borisvolegov/furious/stl/L1 Frame Base Alignment Pin.STL

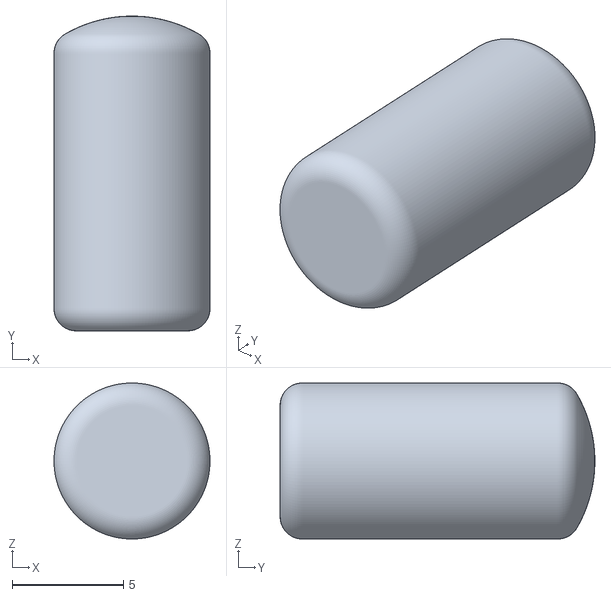
[picture p1: CAD file, 2023-03-07]
stl/L1 Frame Base Alignment Pin.STL
7.00 x 14.1 x 7.00
