borisvolegov/furious/stl/L1 Frame Base original.STL

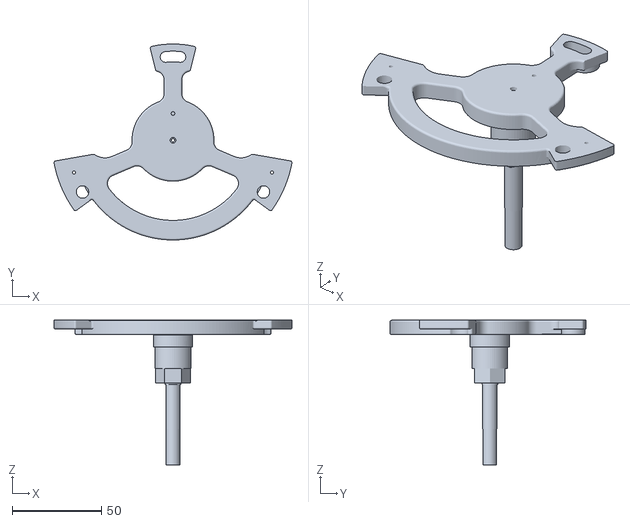
[picture p2: CAD file, 2023-03-07]
stl/L1 Frame Base original.STL
133.6 x 110.0 x 81.1
