borisvolegov/furious/stl/L1 Balance Shaft 2.STL

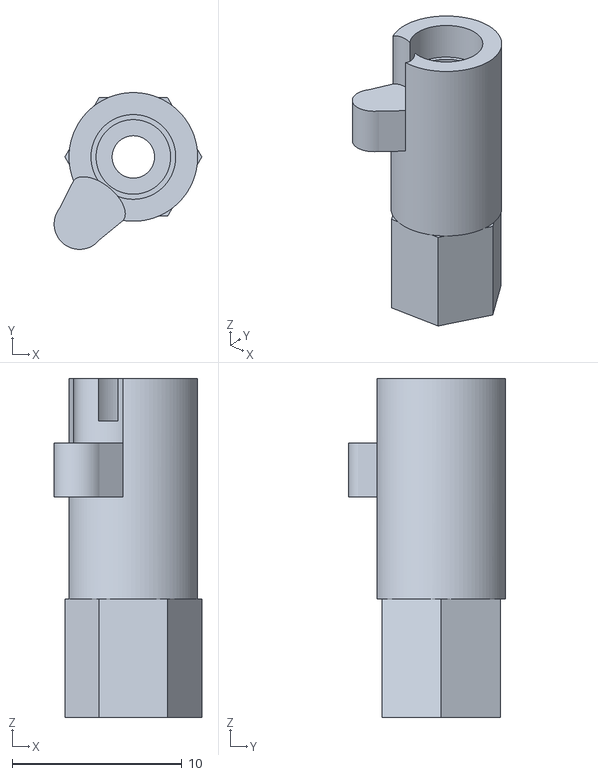
[picture p3: CAD file, 2023-03-07]
stl/L1 Balance Shaft 2.STL
8.71 x 9.25 x 20.0
