borisvolegov/furious/stl/L3 Frame Ring Gear.STL

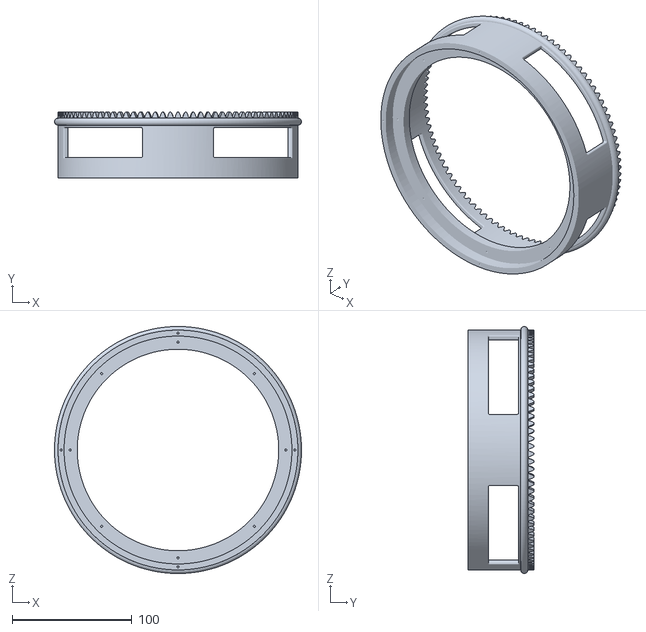
[picture p4: CAD file, 2023-03-07]
stl/L3 Frame Ring Gear.STL
206.0 x 54.9 x 206.0
