borisvolegov/furious/stl/2x1mm Bearing Spacer BINARY.stl

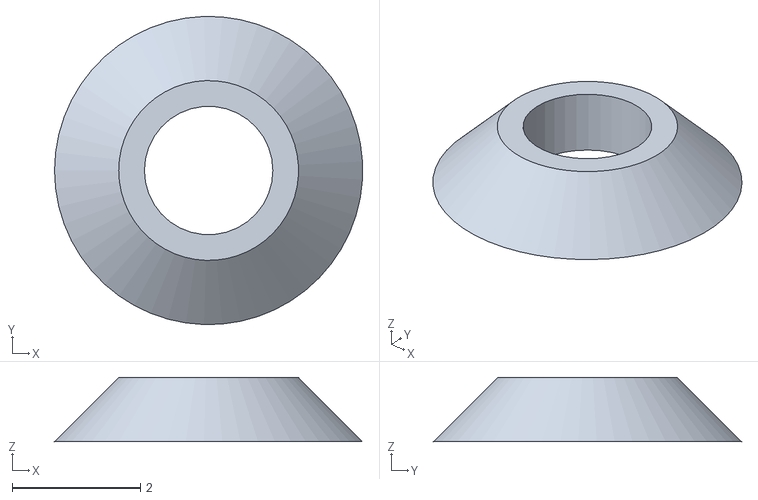
[picture p5: CAD file, 2023-03-07]
stl/2x1mm Bearing Spacer BINARY.stl
4.80 x 4.80 x 1.00
