borisvolegov/furious/stl/L3 Frame.STL

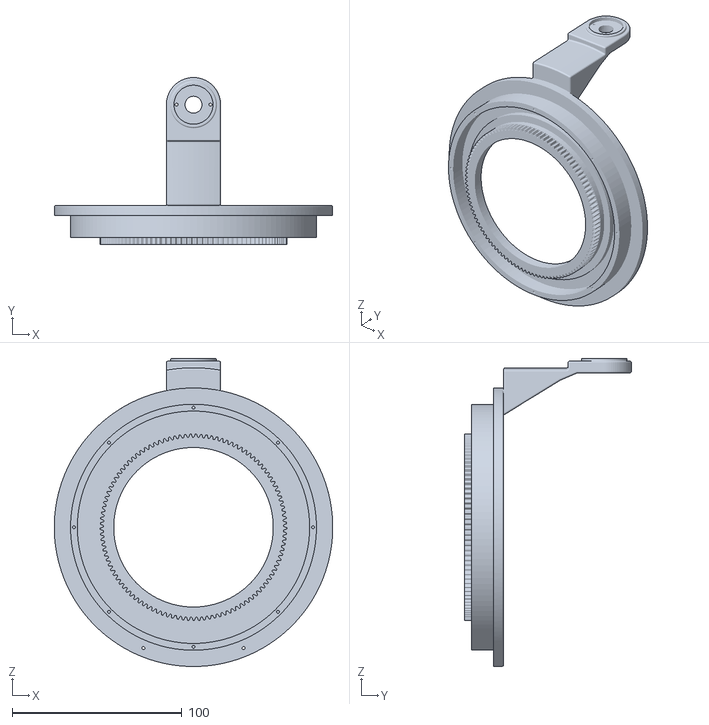
[picture p6: CAD file, 2023-03-07]
stl/L3 Frame.STL
164.2 x 98.4 x 181.6
