borisvolegov/furious/stl/L1 Escape Wheel.STL

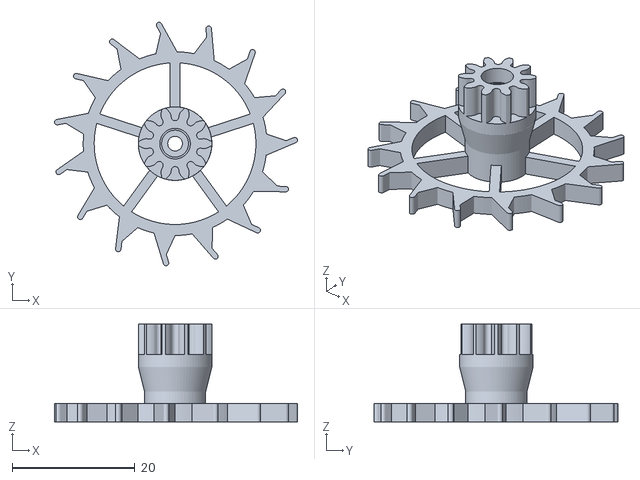
[picture p7: CAD file, 2023-03-07]
stl/L1 Escape Wheel.STL
39.7 x 39.8 x 16.0
