borisvolegov/furious/stl/L3 Crown Gear b.STL

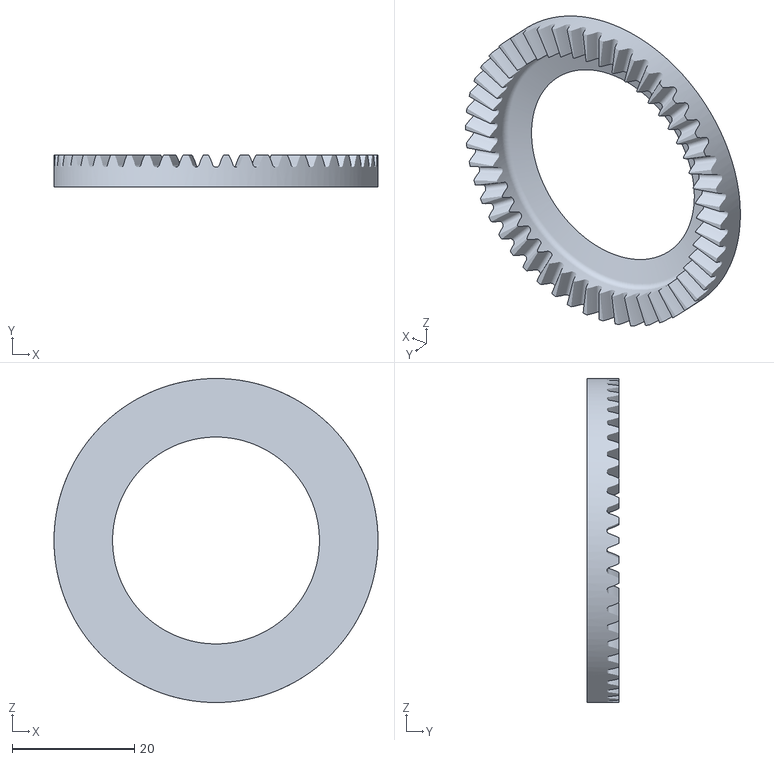
[picture p8: CAD file, 2023-03-07]
stl/L3 Crown Gear b.STL
53.0 x 5.30 x 53.0
