borisvolegov/furious/stl/L1 Fork 3.STL

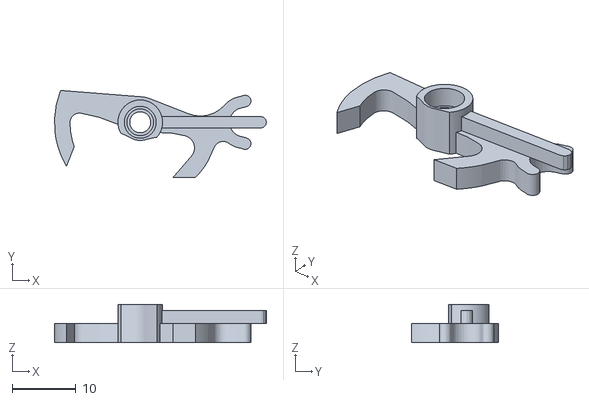
[picture p9: CAD file, 2023-03-07]
stl/L1 Fork 3.STL
33.2 x 13.7 x 6.00
