borisvolegov/furious/stl/L1 Bearing Spacer Upper.STL

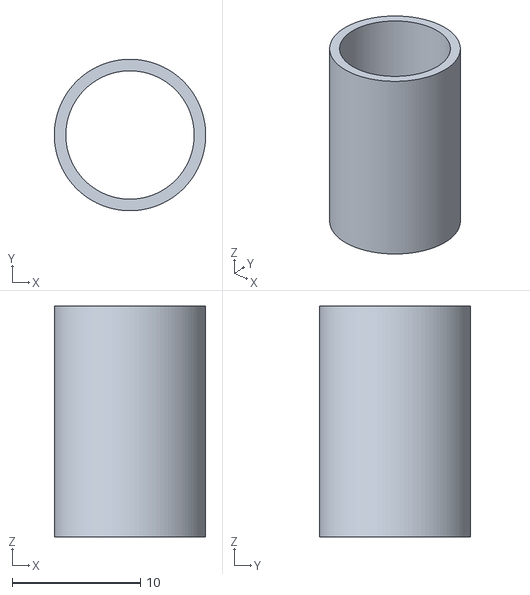
[picture p10: CAD file, 2023-03-07]
stl/L1 Bearing Spacer Upper.STL
11.8 x 11.8 x 18.0
