borisvolegov/furious/stl/L3 Bearing Race Upper.STL

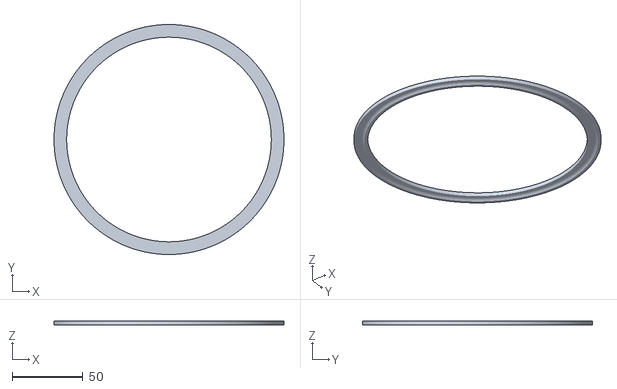
[picture p11: CAD file, 2023-03-07]
stl/L3 Bearing Race Upper.STL
163.0 x 163.0 x 2.50
