borisvolegov/furious/stl/L2 T25 M2 3mm Gear.STL

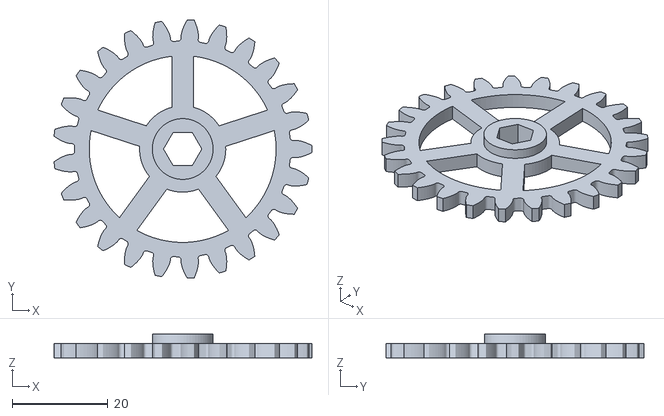
[picture p12: CAD file, 2023-03-07]
stl/L2 T25 M2 3mm Gear.STL
53.9 x 54.0 x 5.00
