borisvolegov/furious/stl/L1 Balance Spring End Mount.STL

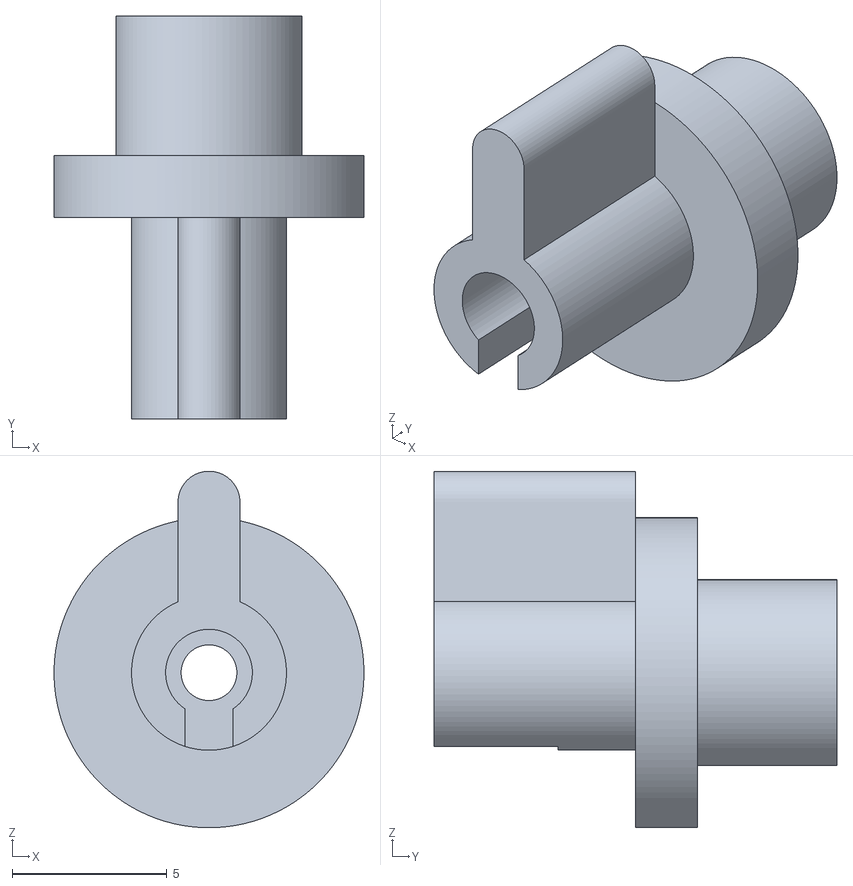
[picture p13: CAD file, 2023-03-07]
stl/L1 Balance Spring End Mount.STL
10.00 x 13.0 x 11.5
