borisvolegov/furious/stl/L1 Fork 2.STL

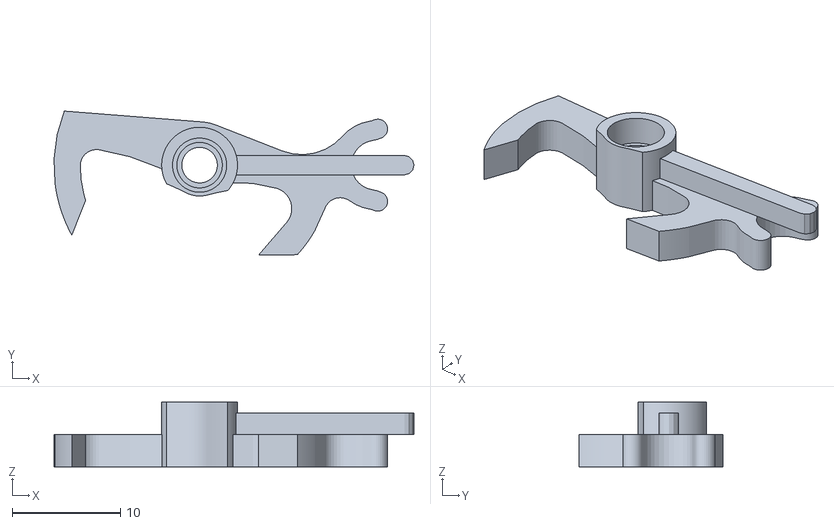
[picture p14: CAD file, 2023-03-07]
stl/L1 Fork 2.STL
33.2 x 13.3 x 6.00
