borisvolegov/furious/stl/L2 Drive Gear.STL

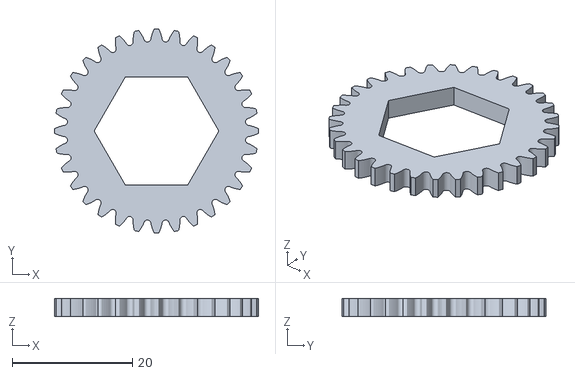
[picture p15: CAD file, 2023-03-07]
stl/L2 Drive Gear.STL
34.0 x 34.0 x 3.00
