borisvolegov/furious/stl/L2 Upper Body Loading Plate Pin.STL

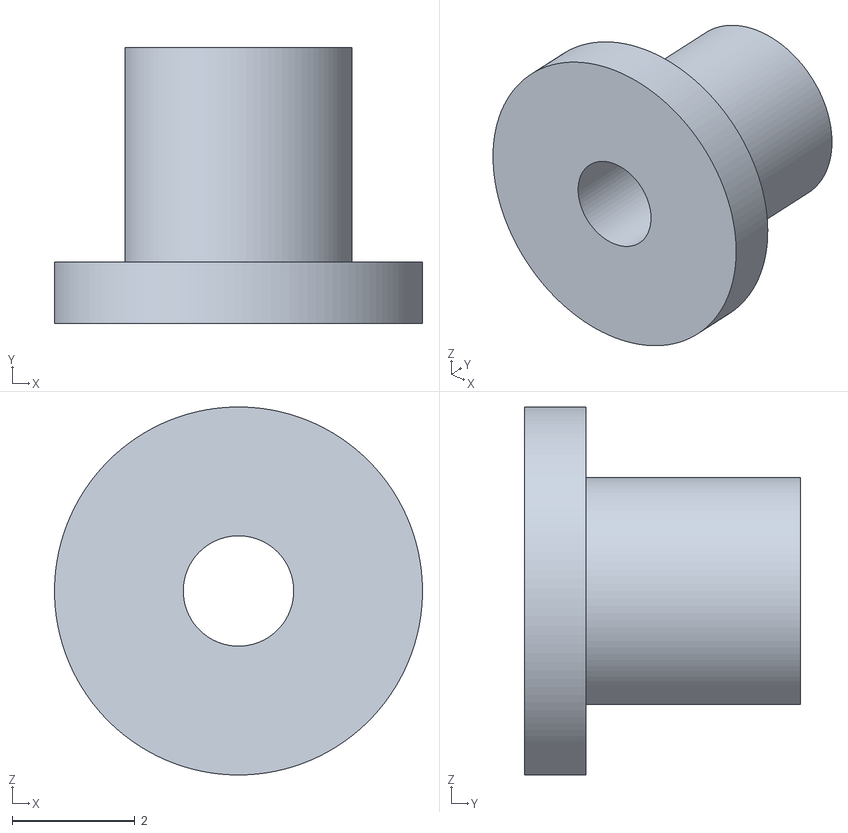
[picture p16: CAD file, 2023-03-07]
stl/L2 Upper Body Loading Plate Pin.STL
6.00 x 4.50 x 6.00
