borisvolegov/furious/stl/L2 Lower Body Trellis2.STL

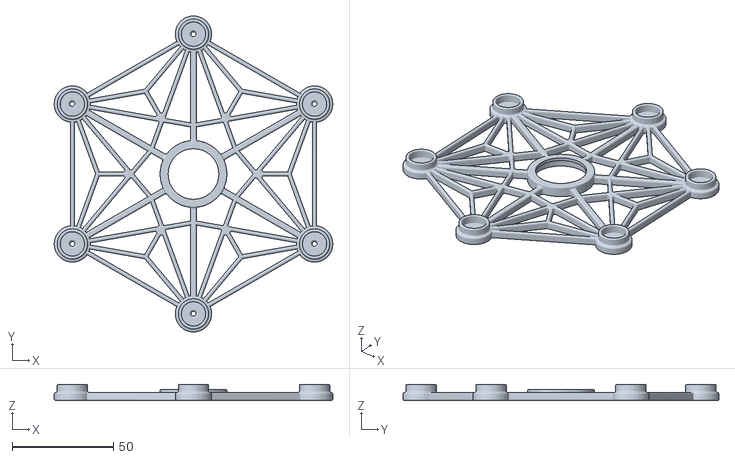
[picture p17: CAD file, 2023-03-07]
stl/L2 Lower Body Trellis2.STL
137.5 x 155.9 x 8.00
