borisvolegov/furious/stl/L2 Upper Body Loading Plate Lower.STL

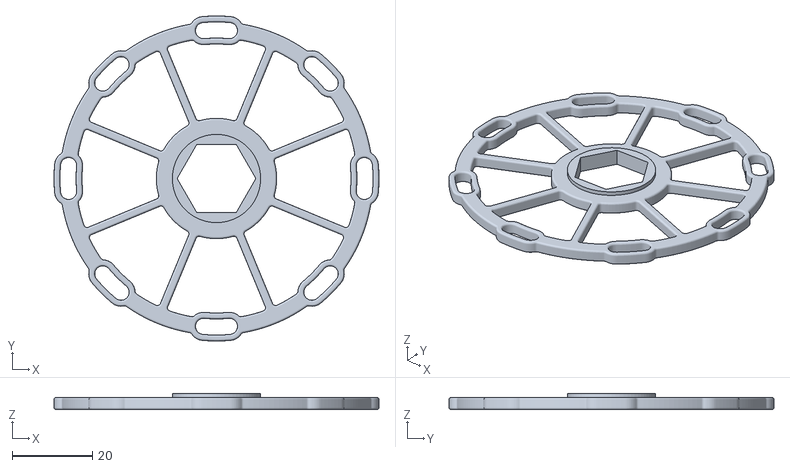
[picture p18: CAD file, 2023-03-07]
stl/L2 Upper Body Loading Plate Lower.STL
81.0 x 81.0 x 4.00
