borisvolegov/furious/stl/L3 Crown Gear a.STL

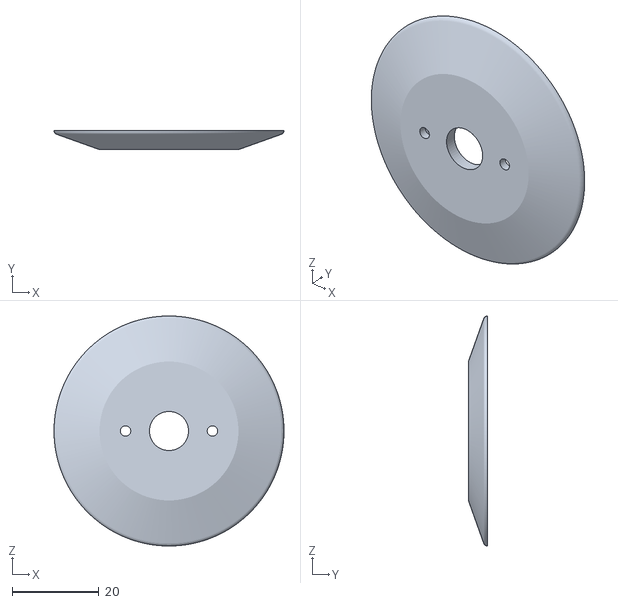
[picture p19: CAD file, 2023-03-07]
stl/L3 Crown Gear a.STL
53.0 x 4.45 x 53.0
