borisvolegov/furious/stl/L2 Torque Spring.STL

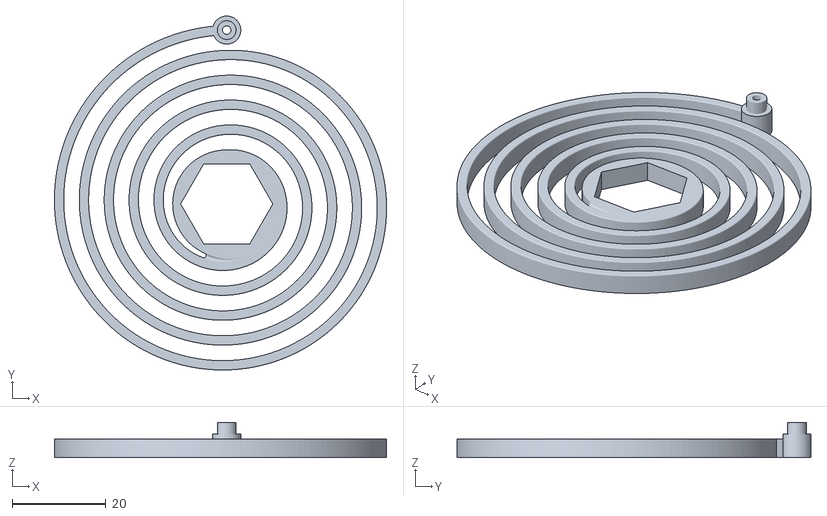
[picture p20: CAD file, 2023-03-07]
stl/L2 Torque Spring.STL
70.7 x 75.3 x 7.50
