borisvolegov/furious/stl/L1 Fork.STL

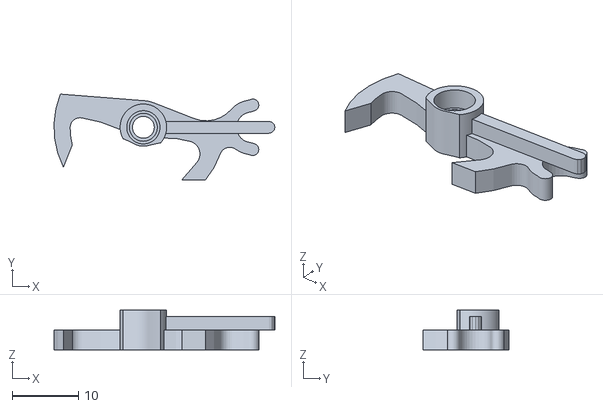
[picture p21: CAD file, 2023-03-07]
stl/L1 Fork.STL
33.2 x 12.9 x 6.00
