borisvolegov/furious/stl/Jewel 6mm.STL

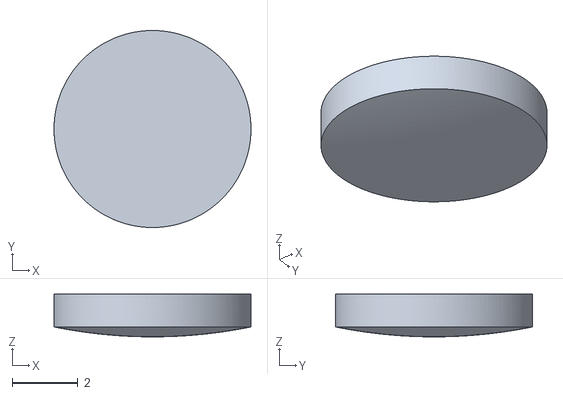
[picture p22: CAD file, 2023-03-07]
stl/Jewel 6mm.STL
6.00 x 6.00 x 1.30
