borisvolegov/furious/stl/2_5x3 Bearing Spacer.stl

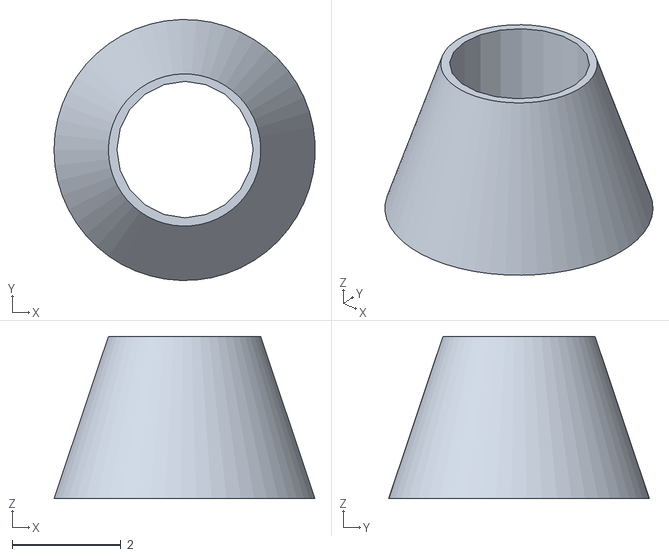
[picture p23: CAD file, 2023-03-07]
stl/2_5x3 Bearing Spacer.stl
4.80 x 4.80 x 2.99
