borisvolegov/furious/stl/2_5x1mm Bearing Spacer.stl

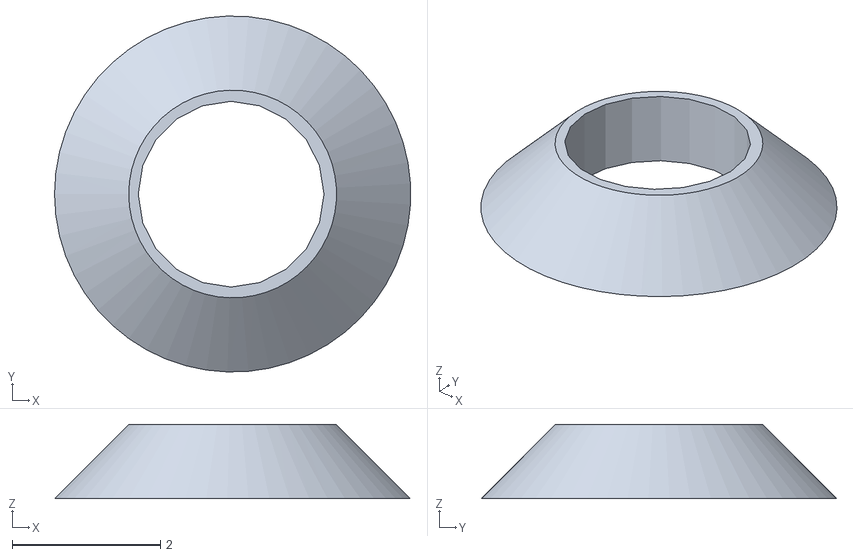
[picture p24: CAD file, 2023-03-07]
stl/2_5x1mm Bearing Spacer.stl
4.80 x 4.80 x 1.00
