borisvolegov/furious/stl/L1 Balance Spacer.STL

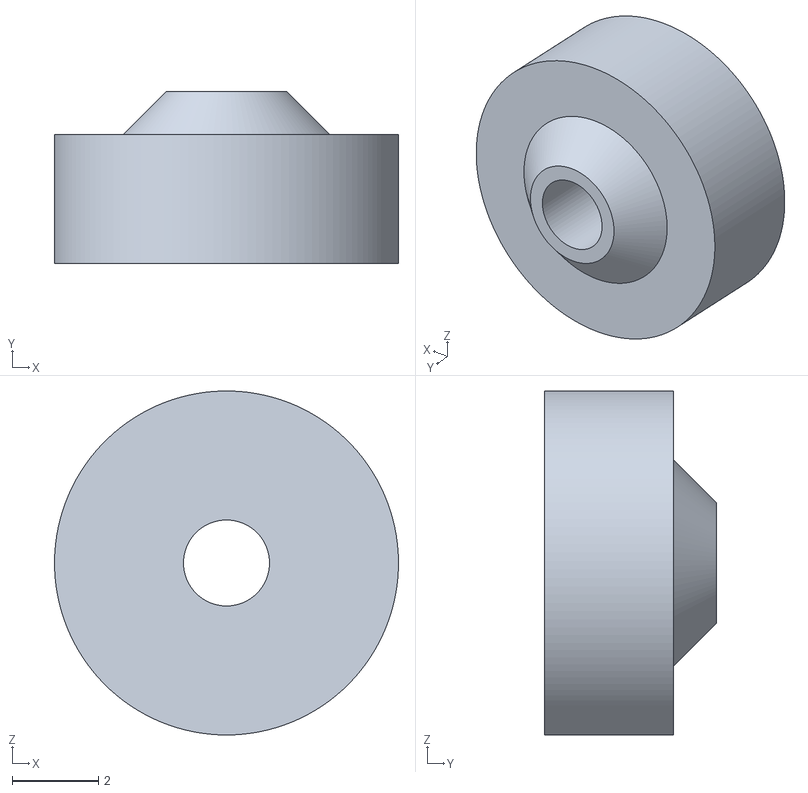
[picture p25: CAD file, 2023-03-07]
stl/L1 Balance Spacer.STL
8.00 x 4.00 x 8.00
