borisvolegov/furious/stl/Base Drive Outer Ring.STL

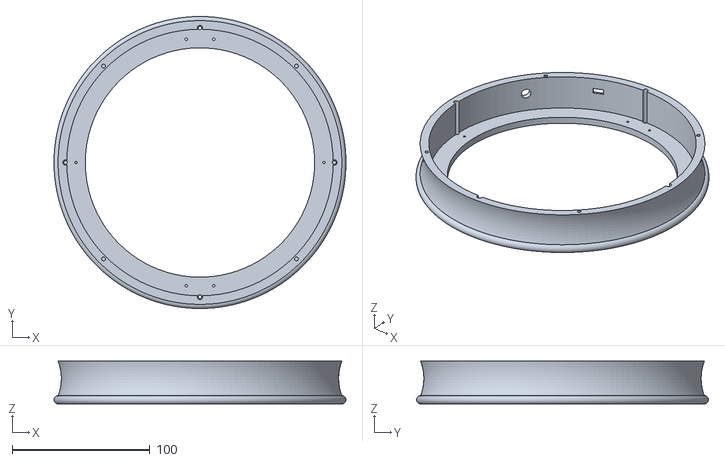
[picture p26: CAD file, 2023-03-07]
stl/Base Drive Outer Ring.STL
212.0 x 212.0 x 31.0
