borisvolegov/furious/stl/L1 Balance Wheel.STL

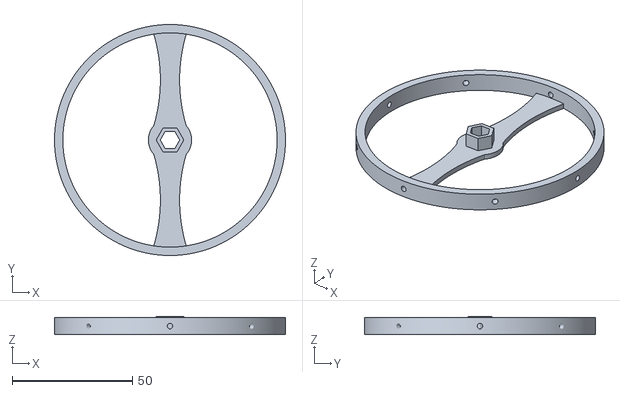
[picture p27: CAD file, 2023-03-07]
stl/L1 Balance Wheel.STL
96.0 x 96.0 x 7.50
