borisvolegov/furious/stl/L2 Upper Body Loading Plate Upper.STL

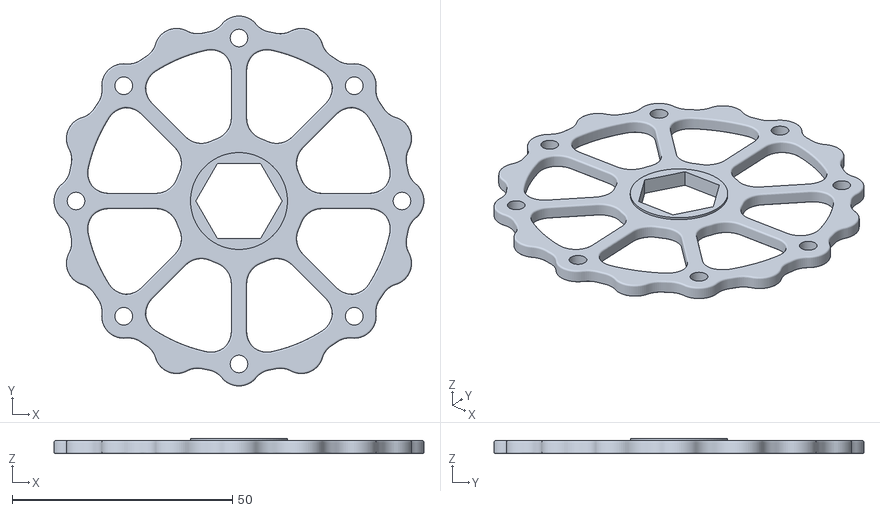
[picture p28: CAD file, 2023-03-07]
stl/L2 Upper Body Loading Plate Upper.STL
84.0 x 84.0 x 3.50
