borisvolegov/furious/stl/L1 Bearing Spacer Lower.STL

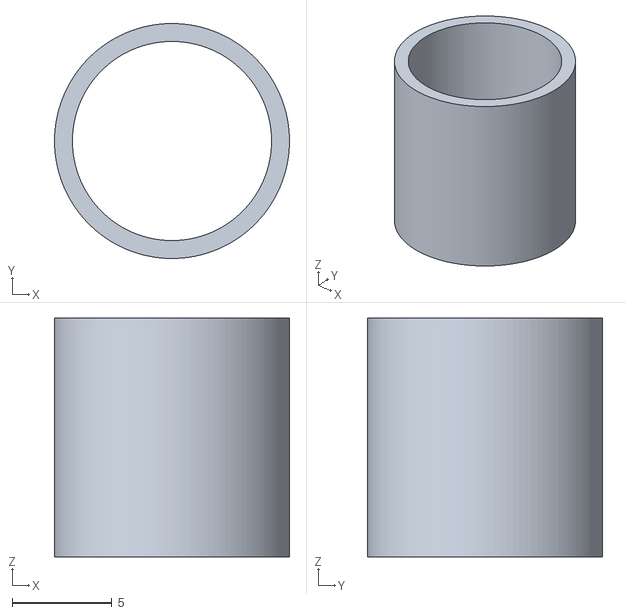
[picture p29: CAD file, 2023-03-07]
stl/L1 Bearing Spacer Lower.STL
11.8 x 11.8 x 12.0
