borisvolegov/furious/stl/L3 Frame Support.STL

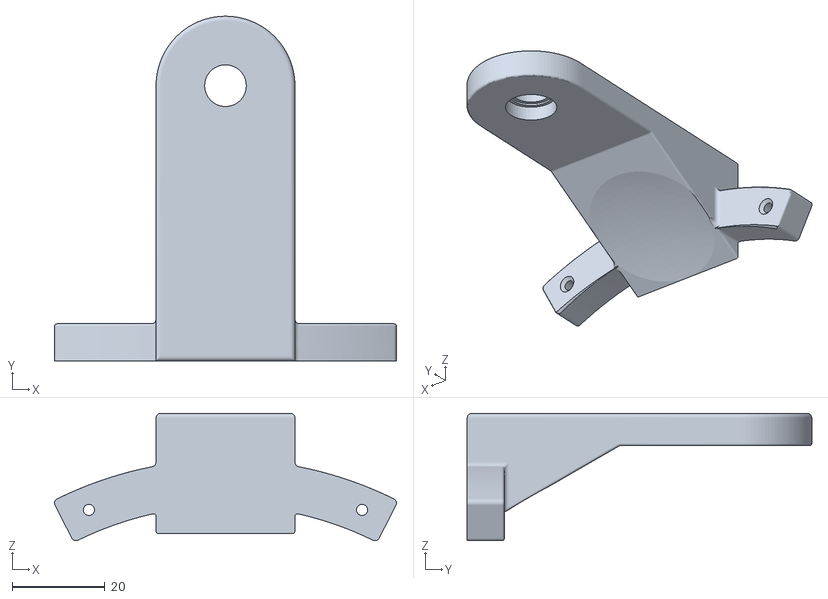
[picture p30: CAD file, 2023-03-07]
stl/L3 Frame Support.STL
73.8 x 74.4 x 27.5
