borisvolegov/furious/(list of files, cad)

Other CAD files:
stl/L1 Frame Base.stl
stl/L2 Thrust Bearing Washer.STL
stl/Screw 12mm.STL
stl/Screw 7mm End Cap.STL
stl/Screw 9mm Seat.STL
stl/Screw 9mm w screw hole.STL
